FandSonthesizer/WireHead-Delay/README.md

# WireHead-Delay
This PT2399 based delay is inspired by a saturated tape delay. We added a distortion unit into the feedback-loop of the delay.
The distortion can be set to nearly clean or heavily distorted.

Check out our sound demo on youtube: https://www.youtube.com/watch?v=yOvposX5Qkg
