FandSonthesizer/WireHead-Delay/WireHead/WireHead.kicad_pcb

## KiCad design WireHead/WireHead.kicad_pcb (2020-11-30)

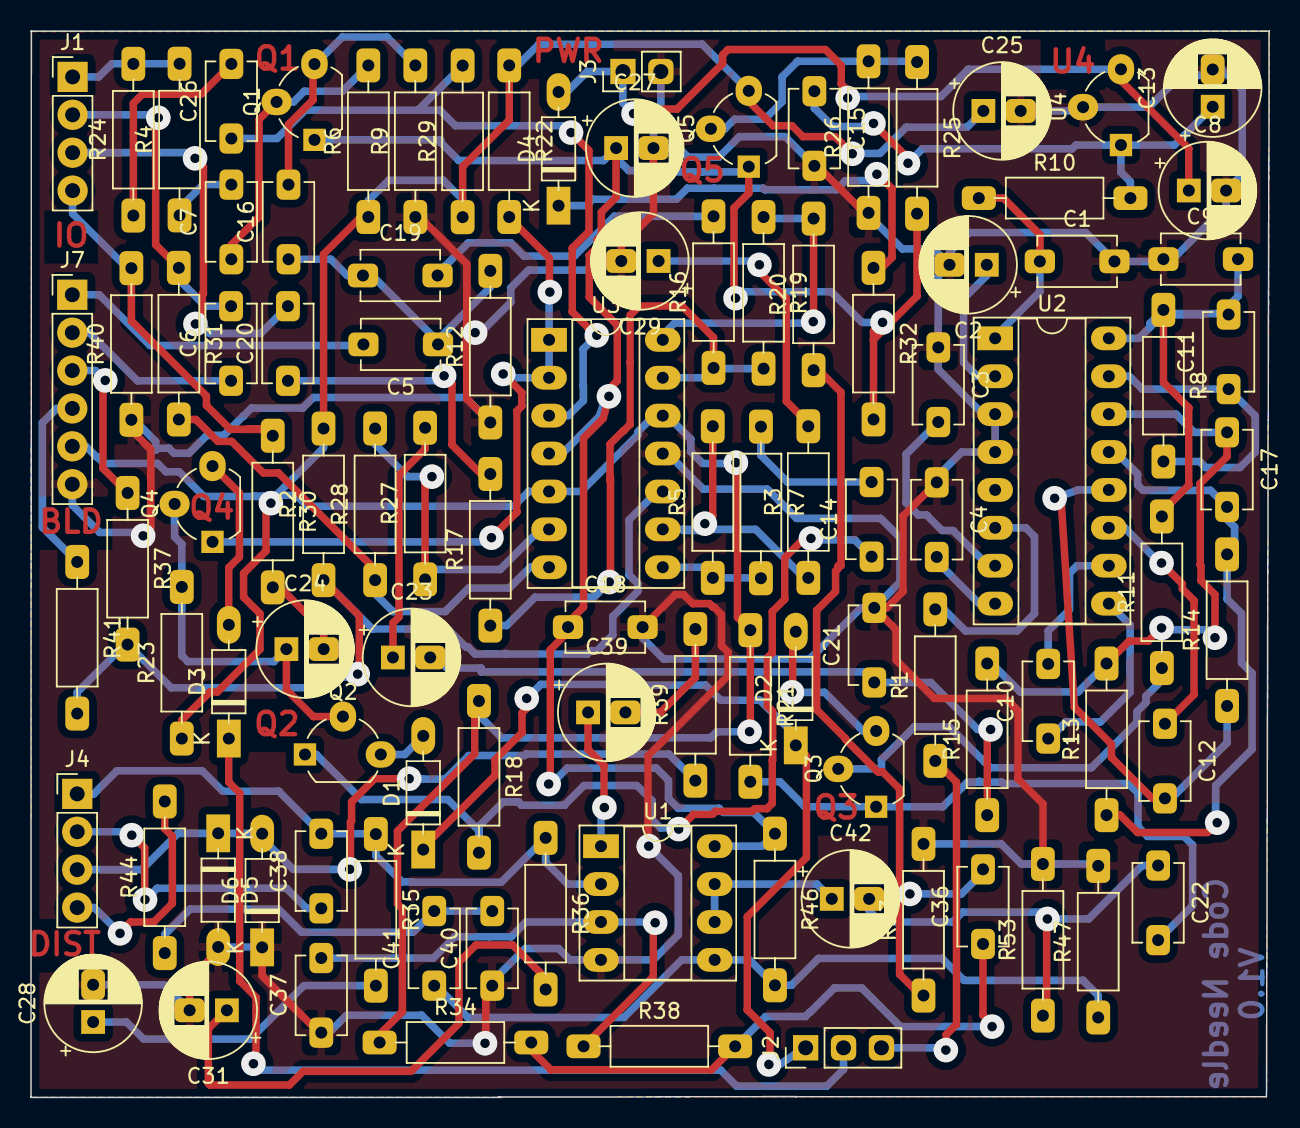
[picture p1: board WireHead.kicad_pcb from above]

Board: 2 copper layers, 83.0 x 71.5 mm, 102 parts (0 on the bottom side), 74 nets.

Parts:
C1, C3, C4, C10, C12, C15, C18, C21, C26: 100n; Kondensator_Keramik
C2: 47u; Elko_D6.3mm_P2.50mm
C5, C6, C19, C20, C22: 150n; Kondensator_Keramik
C7, C14, C16: 47n; Kondensator_Keramik
C8, C42: 1u; Elko_D6.3mm_P2.50mm
C9: 5,6n; Kondensator_Keramik
C11, C17: 560p; Kondensator_Keramik
C13: 100u; Elko_D6.3mm_P2.50mm
C23: 10u; Elko_D6.3mm_P2.50mm
C24: 22u; Elko_D6.3mm_P2.50mm
C25: 33u; Elko_D6.3mm_P2.50mm
C27: 470u; Elko_D6.3mm_P2.50mm
C28: 2,2u; Elko_D6.3mm_P2.50mm
C29: 3,3u; Elko_D6.3mm_P2.50mm
C31, C39: 4,7u; Elko_D6.3mm_P2.50mm
C36, C41: 22n; Kondensator_Keramik
C37: 1n; Kondensator_Keramik
C38: 680n; Kondensator_Keramik
C40: 3,3n; Kondensator_Keramik
D1, D2, D3, D4, D5, D6: 1N4148; Diode_Horizontal
J1: IO; PinHeader_1x04_P2.54mm_Vertical_NIK
J2: BYPassSW; Stift_0x3
J3: Power; Stift_x02
J4: Distortion; PinHeader_1x04_P2.54mm_Vertical_NIK
J7: BlendMix; PinHeader_1x06_P2.54mm_Vertical_NIK
Q1: BC549; TO-92_Wide_NIK
Q2, Q3, Q4: 2n5457; TO-92_Wide_NIK
Q5: 2N3904; TO-92_Wide_NIK
R1, R4, R7, R20, R24, R30, R31, R38, R39: 1k; Widerstand_liegend
R2, R6, R12, R18, R21, R22, R23, R29, R33, R34, R40, R46, R47: 1M; Widerstand_liegend
R3, R9, R26, R27, R37, R41, R53: 10k; Widerstand_liegend
R5, R8, R11, R13, R14: 20k; Widerstand_liegend
R10, R32: 10; Widerstand_liegend
R15: 4,7k; Widerstand_liegend
R16: 47k; Widerstand_liegend
R17, R19: 100k; Widerstand_liegend
R25: 9,1k; Widerstand_liegend
R28: 30k; Widerstand_liegend
R35: 47; Widerstand_liegend
R36: 560; Widerstand_liegend
R44: 1,5k; Widerstand_liegend
U1: TL072; DIP-8_W7.62mm_Socket_LongPads
U2: PT2399; DIP-16_W7.62mm_Socket_LongPads
U3: TL074; DIP-14_W7.62mm_Socket_LongPads
U4: L78L05_TO92; TO-92_Wide_NIK

Connections:
AudioIn: J1.1, R4.2, R24.2
AudioOut: J1.4, R30.1, R40.2
AudioOut_a: C14.1, Q2.1, R18.2
BP_N: D1.1, D2.1, J2.1
BP_P: D3.1, J2.2
BlendCleanIn: J7.3, R37.1
BlendWetIn: J7.4, R41.1
Clean: C5.1, C16.1, C19.1, R12.2
CleanByP: Q4.1, R22.2, U3.1, U3.2
Delay_1: J2.3, R1.1
Distortion_In: C36.2, R20.1, R33.1
Distortion_Out: C22.1, C42.2, R53.1
FeedBack_1: C6.2, J1.2, R31.1
FeedBack_2: C20.2, J1.3
GND: C1.2, C2.2, C3.1, C4.1, C8.2, C9.1, C13.2, C15.2, C18.2, C21.2, C25.2, C27.2, C28.2, C29.2, C31.2, C37.1, C40.1, D5.2, D6.1, J3.2, J7.6, R9.1, R12.1, R26.1, R33.2, R40.1, R47.2, R53.2, U1.4, U2.3, U2.4, U3.11, U4.2
unnamed: C2.1, U2.2
unnamed: C3.2, U2.7
unnamed: C4.2, U2.8
unnamed: C5.2, J7.1
unnamed: C6.1, J7.2
unnamed: C7.1, Q1.2, R6.2
unnamed: C7.2, R4.1
unnamed: C10.1, U2.9
unnamed: C10.2, U2.10
unnamed: C11.1, R8.2, U2.15
unnamed: C9.2, C11.2, R8.1, R11.2, U2.16
unnamed: C12.1, U2.11
unnamed: C12.2, R14.1, U2.12
unnamed: C13.1, C15.1, R10.2, U4.1
unnamed: C14.2, R7.1
unnamed: C16.2, Q1.3, R9.2
unnamed: C17.1, R13.2, R15.2, U2.14
unnamed: C17.2, R13.1, R14.2, U2.13
unnamed: C19.2, R16.2
unnamed: C20.1, R17.2
unnamed: C21.1, C23.2, R15.1
unnamed: C22.2, Q3.1, R21.2
unnamed: C24.1, Q2.2, Q4.2, R23.2
unnamed: C24.2, R30.2
unnamed: C26.1, R29.2, U3.3
unnamed: C26.2, R24.1
unnamed: C28.1, R35.2
unnamed: C29.1, R3.2
unnamed: C31.1, R36.2
unnamed: C36.1, R34.2, R38.2
unnamed: C37.2, R38.1, U1.3
unnamed: C39.1, U1.1
unnamed: C39.2, R39.2
unnamed: C40.2, C41.2, R44.1
unnamed: C41.1, R46.2, R47.1, U1.5
unnamed: C42.1, U1.6, U1.7
unnamed: D1.2, Q2.3
unnamed: D2.2, Q3.3
unnamed: D3.2, Q4.3
unnamed: D4.1, R32.1
unnamed: Q3.2, R11.1
unnamed: Q5.2, R25.1, R26.2
unnamed: R1.2, U2.6
unnamed: R2.1, R37.2, R41.2, U3.10
unnamed: R3.1, R5.2, U3.9
unnamed: R5.1, R7.2, U3.8
unnamed: R16.1, R17.1, R19.2, U3.13
unnamed: R19.1, R20.2, U3.14
unnamed: R27.1, R28.2, U3.6
unnamed: R28.1, R31.2, U3.7
PTOut: C23.1, R27.2
Smooth_1: C38.2, J4.1, R35.1, R36.1, U1.2
Smooth_23: C38.1, J4.2
Tone_1: D5.1, D6.2, J4.3, R39.1
Tone_23: J4.4, R44.2
V+: C18.1, C27.1, Q1.1, Q5.1, R25.2, R32.2, R46.1, U1.8, U3.4
VBat: C8.1, D4.2, J3.1, U4.3
Vcc: C1.1, R10.1, U2.1
Vref: C25.1, J7.5, Q5.3, R2.2, R6.1, R18.1, R21.1, R22.1, R23.1, R29.1, R34.1, U3.5, U3.12
